williamalu/k20_synth/k20_synth.kicad_pcb

## KiCad design k20_synth.kicad_pcb (2017-12-01)

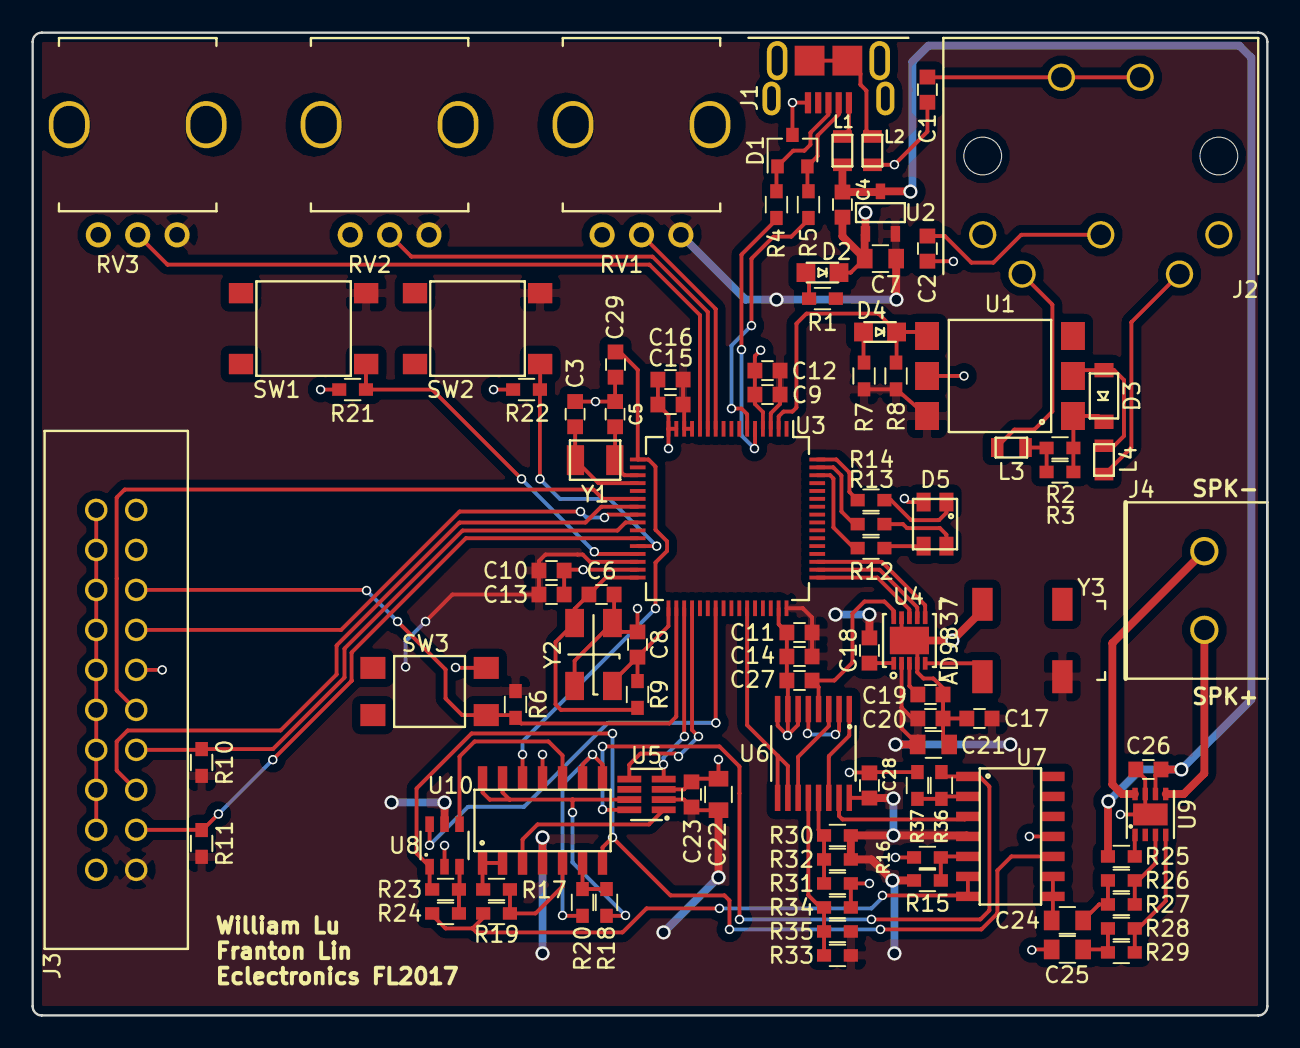
[picture p1: board k20_synth.kicad_pcb from above]

Board: 2 copper layers, 78.4 x 62.4 mm, 98 parts (0 on the bottom side), 79 nets.

Parts:
C1, C2, C9, C10, C11, C15, C16, C17, C19, C20, C23, C28, C29: 0.1uF; C_0603
C3, C5, C6, C8: 22pF; C_0603
C4, C12, C13, C14, C26: 1uF; C_0603
C7, C21, C22: 10uF; C_0805
C18: 10nF; C_0603
C24, C25: 33uF; C_0805
C27: 1nF; C_0603
D1: D_TVS_x2_AAC; SOT-23
D2, D4: LED; LTST-C170TGKT
D3: D; 1N4148W-TP
D5: LED_CRGB_altpin; XZM2CRKM2DGFBB45SCCB
J1: USB_OTG_PWR; 2040002-1
J2: MIDI-DIN-5; SDF-50J
J3: Conn_02x10_Odd_Even; SBH11-PBPC-D10-ST-BK
J4: Spk_Screw_Terminal_01x02; OSTTA020161
L1, L2: 330; MPZ2012S331AT000
L3, L4: 1k@100MHz; MMZ2012R102AT000
R1, R7, R37: 1k; R_0603
R2: 806; R_0603
R3: 301; R_0603
R4, R5: 33; R_0603
R6, R15, R16, R17, R18, R19, R20, R21, R22, R25: 10k; R_0603
R8: 200; R_0603
R9: 1M; R_0603
R10, R11: 100k; R_0603
R12, R13: 30.1; R_0603
R14: 127; R_0603
R23: 6.98k; R_0603
R24: 1.58k; R_0603
R26, R27, R28, R29: 909; R_0603
R30: 499k; R_0603
R31: 3.01k; R_0603
R32, R35: 12.7k; R_0603
R33: 2M; R_0603
R34: 143; R_0603
R36: 4.02k; R_0603
RV1, RV2, RV3: POT; PTV09A-4020U
SW1, SW2: SW_Push_Dual_x2; PTS645SM43SMTR92
SW3: SW_Push_Dual_x2; TL3305AF160QG
U1: H11L1; H11L1S(TA)
U2: MCP1702T-3302E/CB; MCP1702T-3302E
U3: MK20DX128VLH5; LQFP-64_10x10mm_Pitch0.5mm
U4: AD9837; AD9837BCPZ-RL
U5: AD5245BRJZ10-RL7
U6: CD74HC4053PWR
U7, U10: MCP6024; MCP6024T-I(SL)
U8: SN74LVC1G3157; SN74LVC1G3157DBVR
U9: TS4962IQT; TS4962IQT(DFN)
Y1: Crystal; ECS-.327-12.5-34B-TR
Y2: Crystal_GND24; ABM3B-8.000MHZ-B2-T
Y3: SG-636PCE5.0000MC0

Connections:
+3V3: C7.2, C9.1, C10.1, C11.1, C12.1, C13.1, C14.1, C15.1, C16.1, C17.1, C18.2, C20.1, C21.1, C22.2, C23.2, C28.1, J3.1, R1.2, R6.1, R7.1, R8.1, R10.1, R11.1, R15.2, R30.1, R32.1, R33.2, R35.2, RV1.3, RV2.3, RV3.3, SW1.3, SW2.3, U1.6, U2.2, U3.3, U3.13, U3.14, U3.30, U3.48, U4.2, U5.2, U6.16, U7.4, U8.5, U10.4, Y3.4
+5V: C4.2, C26.2, L2.1, R25.1, U2.3, U9.6
/ADC0_DM0: RV1.2, U3.10
/ADC0_DM3: RV3.2, U3.12
/ADC0_DP3: RV2.2, U3.11
/FTM1_CH0: R22.2, SW2.1, U3.28
/FTM1_CH1: R21.2, SW1.1, U3.29
/I2C0_SCL: U3.35, U5.4
/I2C0_SDA: U3.36, U5.5
/JTAG_TCLK: J3.9, U3.22
/JTAG_TDI: J3.5, U3.23
/JTAG_TDO: J3.13, U3.24
/JTAG_TMS: J3.7, R10.2, U3.25
/LED_BLUE: R12.1, U3.62
/LED_GREEN: R13.1, U3.63
/LED_RED: R14.1, U3.64
/MIDI_IN: D4.1, R8.2, U1.4, U3.2
/NORM_WAVEGEN: R36.2, U5.8, U7.1
/PTB16: U3.39, U8.6
/SPI0_PCS0: U3.49, U4.8
/SPI0_SCK: U3.50, U4.7
/SPI0_SOUT: U3.51, U4.6
/USB_DM: R5.1, U3.6
/USB_DP: R4.1, U3.5
/VREF_OUT: C29.1, U3.17, U10.12
/WAVEGEN: C27.1, U4.10, U6.4
/~JTAG_TRST: J3.3, R11.2, U3.27
/~RESET: J3.15, R6.2, SW3.2, U3.34
/~SQUARE: U3.43, U6.9, U6.10
GND: C1.2, C2.2, C3.2, C4.1, C5.2, C6.2, C7.1, C8.2, C9.2, C10.2, C11.2, C12.2, C13.2, C14.2, C15.2, C16.2, C17.2, C19.1, C20.2, C21.2, C22.1, C23.1, C25.2, C26.1, C27.2, C28.2, C29.2, D1.3, D2.1, D5.4, J1.5, J3.4, J3.6, J3.8, J3.10, J3.11, J3.12, J3.14, J3.16, J3.18, J3.20, L1.2, R16.1, R21.1, R22.1, R31.2, R34.2, R37.1, RV1.1, RV2.1, RV3.1, SW3.4, U1.5, U2.1, U3.4, U3.15, U3.16, U3.31, U3.47, U4.4, U4.9, U4.11, U5.3, U6.6, U6.7, U6.8, U7.11, U8.2, U9.7, U9.9, U10.11, Y2.2, Y2.4, Y3.2
unnamed: C1.1, J2.~
unnamed: C2.1, J2.2
unnamed: C3.1, U3.20, Y1.1
unnamed: C5.1, U3.19, Y1.2
unnamed: C6.1, R9.2, U3.32, Y2.3
unnamed: C8.1, R9.1, U3.33, Y2.1
unnamed: C18.1, U4.1
unnamed: C19.2, U4.3
unnamed: C24.1, R26.1, R27.1
unnamed: C24.2, U7.8, U7.9
unnamed: C25.1, R28.1, R29.1
unnamed: D1.1, J1.3, R4.2
unnamed: D1.2, J1.2, R5.2
unnamed: D2.2, R1.1
unnamed: D3.1, R2.1, R3.1, U1.1
unnamed: D3.2, L4.1, U1.2
unnamed: D4.2, R7.2
unnamed: D5.1, R14.2
unnamed: D5.2, R13.2
unnamed: D5.3, R12.2
unnamed: J1.1, L2.2
unnamed: J1.6, L1.1
unnamed: J2.4, L3.2
unnamed: J2.5, L4.2
unnamed: J4.1, U9.8
unnamed: J4.2, U9.5
unnamed: L3.1, R2.2, R3.2
unnamed: R15.1, R16.2, U7.5
unnamed: R17.1, R19.2, U10.5
unnamed: R17.2, U10.1, U10.2
unnamed: R18.1, R20.2, U10.6
unnamed: R18.2, U5.7, U10.13, U10.14
unnamed: R19.1, R24.1, U7.6, U7.7
unnamed: R20.1, U10.8, U10.9
unnamed: R23.1, R24.2, U8.3
unnamed: R23.2, U7.10, U8.1, U10.7
unnamed: R25.2, U9.1
unnamed: R26.2, R27.2, U9.3
unnamed: R28.2, R29.2, U9.4
unnamed: R30.2, R31.1, R32.2, U6.13
unnamed: R33.1, R34.1, R35.1, U6.12
unnamed: R36.1, R37.2, U7.2
unnamed: U4.5, Y3.3
unnamed: U6.1, U6.14
unnamed: U6.2, U6.5
unnamed: U6.3, U6.11
unnamed: U6.15, U7.3
unnamed: U5.1, U10.3
unnamed: U8.4, U10.10
