williamalu/k20_synth/(commit log)

2017-10-30 added kicad gitignore
2017-11-02 converted k20_dev_board project and added beginnings of DDS circuit
    [k20_synth.sch]
2017-11-02 Added DDS oscillator, audio amplifier, wavegen output buffer
    [k20_synth.sch]
2017-11-02 Replaced pot and switch with digipot and mux
    [k20_synth.sch]
2017-11-06 cleaned up gpio, added control pots/buttons
    [k20_synth.sch]
2017-11-06 changed op-amp part to mcp6024/6022
    [k20_synth.sch]
2017-11-13 cleaned up schematic
    [k20_synth.sch]
2017-11-16 Added square wave normalizing circuit
    [k20_synth.sch]
2017-11-16 Created and associated some footprints
    [k20_synth.sch]
2017-11-16 Created and associated more footprints, fixed buttons
    [k20_synth.sch]
2017-11-17 Finished footprints
    [k20_synth.sch]
2017-11-17 Specced audio amplifier blocking caps
    [k20_synth.sch]
2017-11-17 Fixed electrical rules checker problems
    [k20_synth.sch]
2017-11-18 doublechecked footprints
2017-11-18 Attempted some layout or something
    [k20_synth.kicad_pcb, k20_synth.sch]
2017-11-18 Deleted some random no connects
    [k20_synth.sch]
2017-11-18 so many crashes
    [k20_synth.kicad_pcb]
2017-11-18 Finished layout, hopefully it works
    [k20_synth.kicad_pcb, k20_synth.sch]
2017-11-18 Added our names for posterity
    [k20_synth.kicad_pcb]
2017-11-27 Added BOM
    [k20_synth_bom.csv]
2017-11-30 Fixed footprint masks, potentiometer footprints and spacing
    [k20_synth.kicad_pcb, k20_synth.sch]
2017-12-01 updated pot footprint
    [k20_synth.kicad_pcb]
